gadzooks00/snaptics-website/README.md

# snaptics-website

The source files for the open-source project Snaptics, hosted on www.Snaptics.org
