gadzooks00/snaptics-website/Bill of Parts.md

# Bill of Parts

## Modular Haptic Bracelet:

- 5 SG90 Servos (https://www.amazon.com/J-Deal-Micro-Helicopter-Airplane-Controls/dp/B015H5AVZG)
- Teensy 3.2 (https://www.pjrc.com/store/teensy32.html)
- DRV2605L Haptic Controller (for vibration module) **?**(https://www.adafruit.com/product/2305)
- Velcro Strap **where buy??**
- Coin Battery (**what size???**)
- **AA?** Batteries
- Printed parts (1 of each kind of module + Battery and Arduino mounts)

Cost: $40 + Shipping and Filament for printed parts (~$60 total)

## (For each) Stretch Module:

- 1 SG90 Servo
- Stretch Base
- Stretch Tactor

## (For each) Twist Module:

- 1 SG90 Servo
- Twist Base
- Twist Tactor

## (For each) Vibration Module:

- 1 ERM **what kind???**
- Vibration Base
