gadzooks00/snaptics-website/modules/blank/blank_module.STL

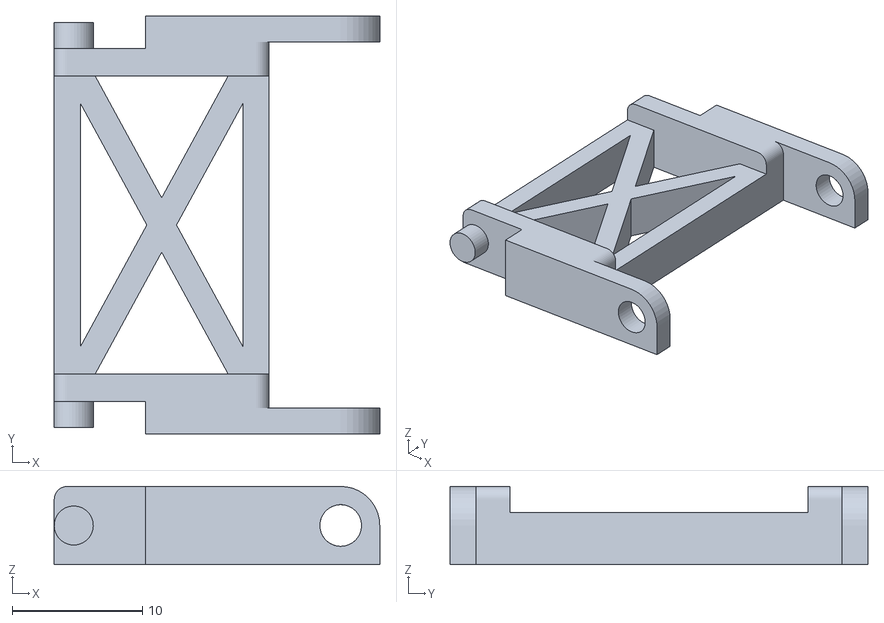
[picture p10: CAD file, 2021-02-02, last stored version]
modules/blank/blank_module.STL
25.0 x 32.1 x 6.00
