gadzooks00/snaptics-website/modules/control/control_module.STL

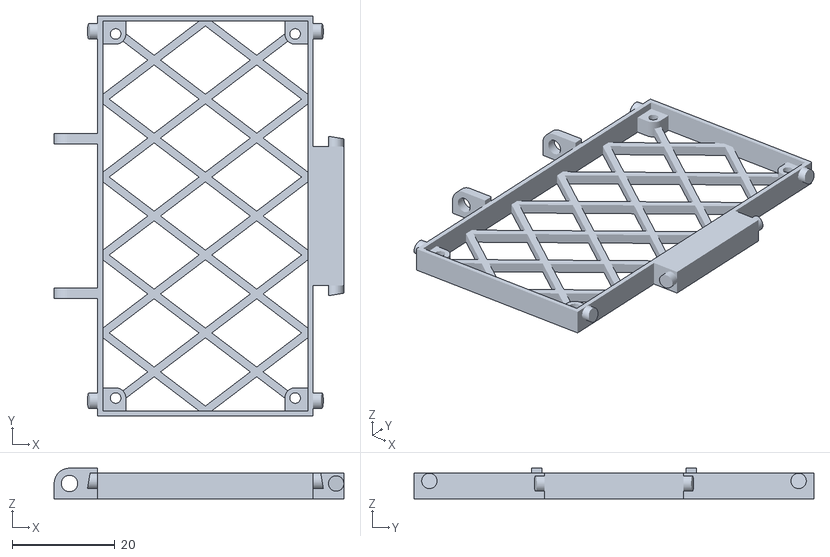
[picture p11: CAD file, 2021-02-02, last stored version]
modules/control/control_module.STL
56.5 x 78.0 x 6.00
