gadzooks00/snaptics-website/modules/power/power_module.STL

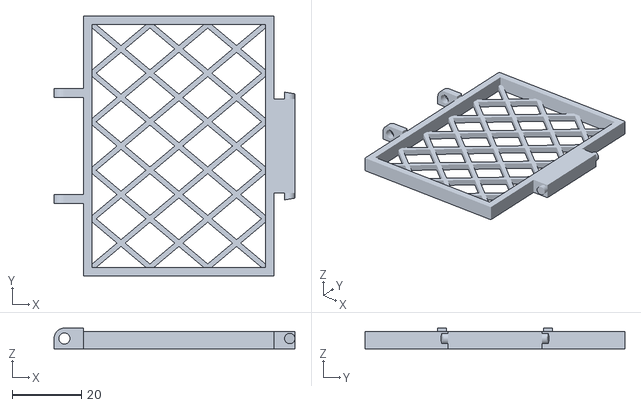
[picture p12: CAD file, 2021-02-02, last stored version]
modules/power/power_module.STL
69.5 x 75.0 x 6.00
