gadzooks00/snaptics-website/modules/stretch/stretch_module.STL

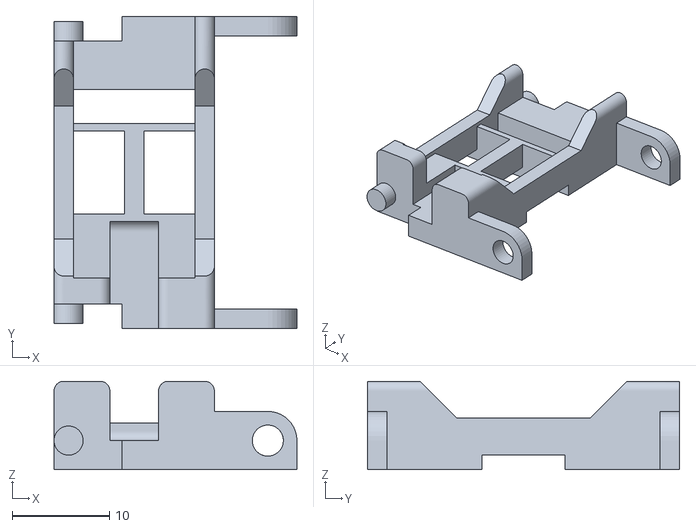
[picture p13: CAD file, 2021-02-02, last stored version]
modules/stretch/stretch_module.STL
25.0 x 32.1 x 9.10
