gadzooks00/snaptics-website/modules/terminal/terminal_module_male.STL

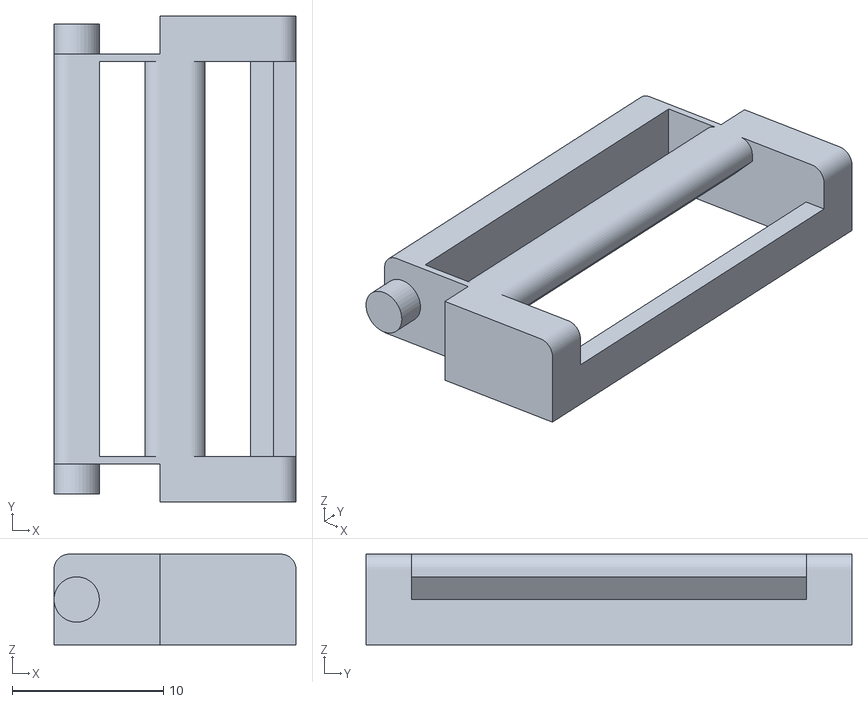
[picture p14: CAD file, 2021-02-02, last stored version]
modules/terminal/terminal_module_male.STL
16.0 x 32.1 x 6.00
