gadzooks00/snaptics-website/modules/twist/twist_clip.STL

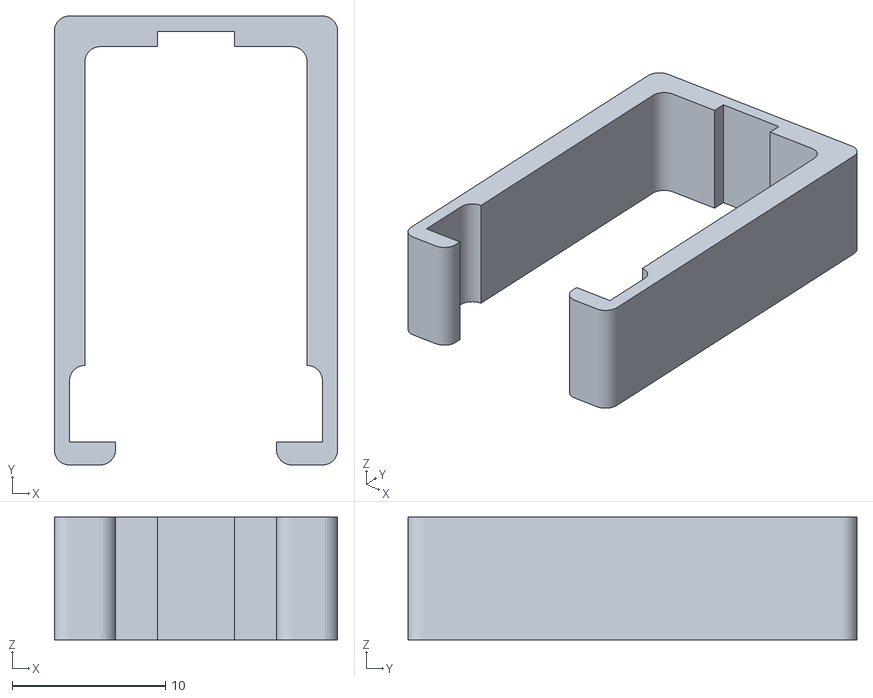
[picture p15: CAD file, 2021-02-02, last stored version]
modules/twist/twist_clip.STL
18.5 x 29.3 x 8.00
