gadzooks00/snaptics-website/modules/stretch/stretch_tactor.STL

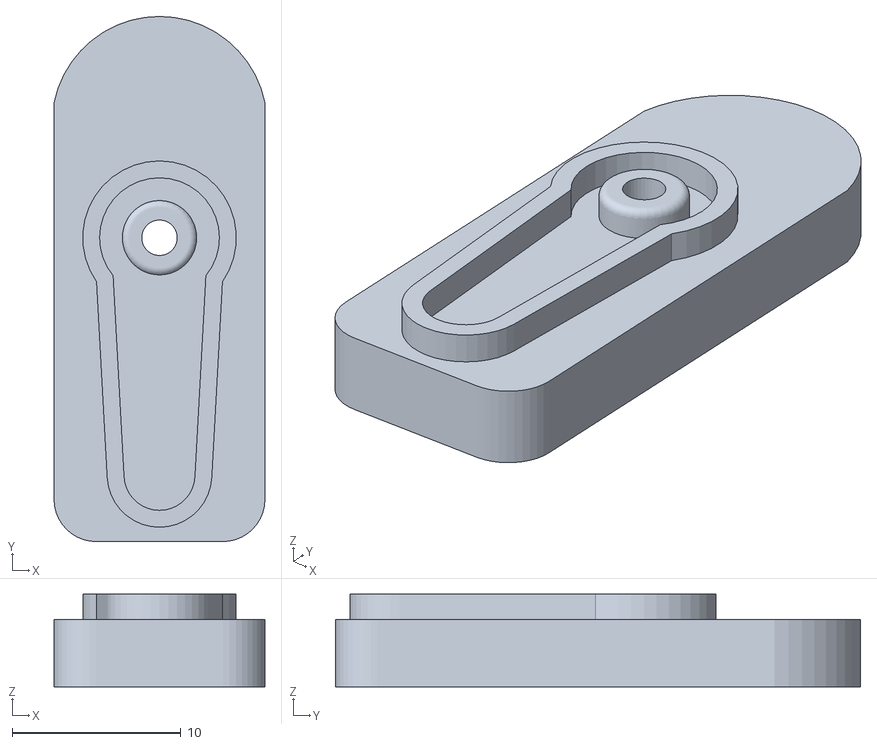
[picture p16: CAD file, 2021-02-02, last stored version]
modules/stretch/stretch_tactor.STL
12.5 x 31.1 x 5.50
