gadzooks00/snaptics-website/modules/terminal/terminal_module_female.STL

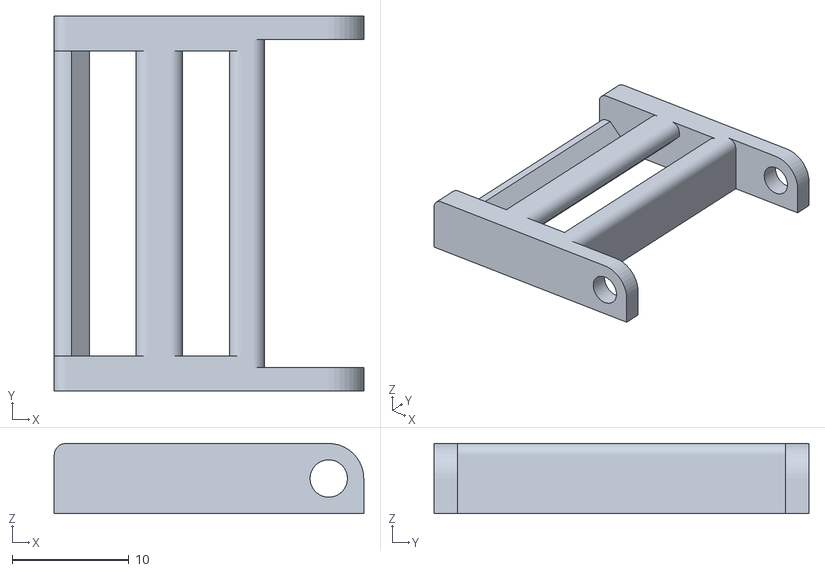
[picture p17: CAD file, 2021-02-02, last stored version]
modules/terminal/terminal_module_female.STL
26.5 x 32.1 x 6.00
