gadzooks00/snaptics-website/modules/twist/twist_tactor.STL

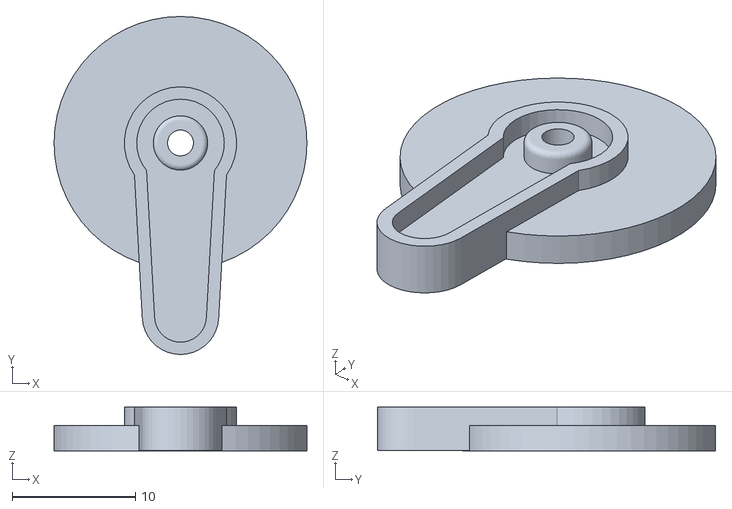
[picture p18: CAD file, 2021-02-02, last stored version]
modules/twist/twist_tactor.STL
20.5 x 27.4 x 3.55
