gadzooks00/snaptics-website/modules/stretch/stretch_clip.STL

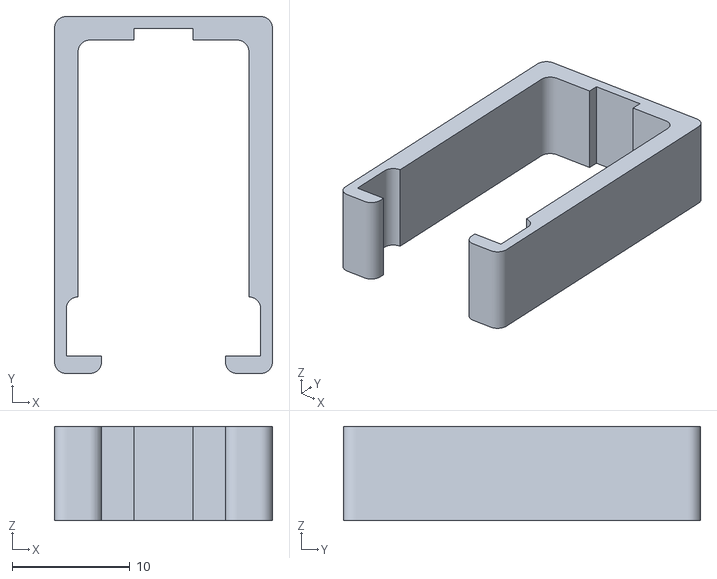
[picture p19: CAD file, 2021-02-02, last stored version]
modules/stretch/stretch_clip.STL
18.5 x 30.3 x 8.00
