gadzooks00/snaptics-website/modules/twist/twist_module.STL

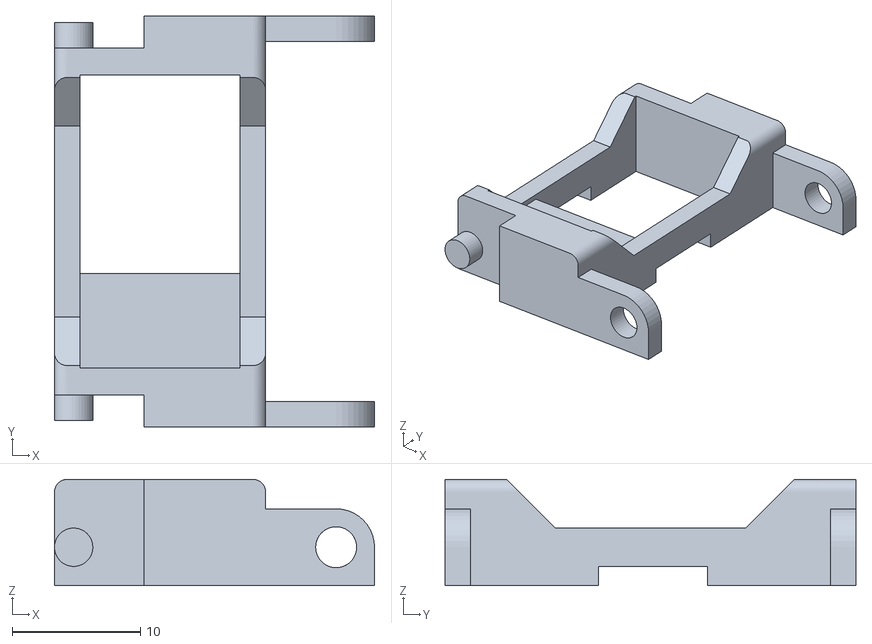
[picture p20: CAD file, 2021-02-02, last stored version]
modules/twist/twist_module.STL
25.0 x 32.1 x 8.30
