gadzooks00/snaptics-website/(list of files, cad)

Other CAD files:
modules/erm_vibration/erm_vibration_module.STL
modules/vibration/vibration_module.STL
