gadzooks00/snaptics-website/(commit log)

2021-02-01 Content update. Text and module folder
    [vibration_module.STL]
2021-02-02 Big content update
    [blank_module.STL, control_module.STL, erm_vibration_module.STL, power_module.STL, stretch_clip.STL, stretch_module.STL, stretch_tactor.STL, terminal_module_female.STL]
2021-02-03 major file structure updates
    [blank_module.STL, control_module.STL, erm_vibration_module.STL, power_module.STL, stretch_clip.STL, stretch_module.STL, stretch_tactor.STL, terminal_module_female.STL]
2021-02-10 electronics pin diagrams
2021-02-26 power module page commit
